microbit-foundation/microbit-reference-design/(threads)

Thread 2 (2017-01-05):

Eagle and KiCad designs don't have the PAD1-3 fix

jaustin, 2017-01-05:
In b2a55fdbed I added a fix from @sjwiseman for the Altium files having PAD1-3 incorrectly mapped out to the external example speaker.

This hasn't yet been added to the KiCad and Eagle designs

Thread 4 (2017-01-06):

contents of micro:bit reference design: web and repo

OwenBrotherwood, 2017-01-06:
From my analysis.

1. https://github.com/microbit-foundation/microbit-reference-design/tree/master/Altium
- should contain the master of the schematic design
- the ascii export, let us call it "ACCEL ASCII" should be included
- it is questionable if any Altium binary blobs for schematics give any meaning in the git repro
- it is questionable if Altium binary blobs for pcb give any meaning in the git repro
2. Concentrate on ensuring the schematic is correct
- remove all pcb designs until this is met and the web should only give a general idea of possibilities with perhaps the main goal of true shareability of schematic design to ensure pcb IRL.
3. Others like Eagle etc etc (the list is endless)
- document import for the interesting list of schematic/pcb sw
- ensure that the import works with active community support for checking
- "if it doesn't work, issue it" and concentrate on issues from people who are actually using the schematic/pcb sw instead of a broad range of possible sw users.

The above are just a few of my thoughts, dependant on feedback to 1 2 3 this issue may come into other areas.

sjwiseman, 2017-01-06:
1) I think that the Altium binary blob _should_ stay. It's the source, like it or not. Everything else is derived.
Yes, any useful derived intermediate files should be published. I didn't think the  Accel was particularly useful. (It's also not something that  I can generate automatically from the outjob.)
2) Not at all convinced by this. The PCB is (imho) an important part of the design. If people want to generate derivative works rather than starting from scratch, it'll save a few days. It's also something to swipe footprints from).
3) Yes! Import was surprisingly flaky and unsatisfactory. Given the maker movement's reliance on reuse, I'm surprised just how hard / bad it was. Obviously I'm spoilt with Altium's generally competent importers.
I'm partly assuming that I'm doing it wrong(tm), and am hoping for assistance from seasoned users of those packages.
I'm somewhat busy at the moment, but will  watch, and do what I can. Shout if there's anything in particular.

OwenBrotherwood, 2017-01-06:
1: Jep: let the blob be in: but never without a commit without the ASCII as documentation for change.
2: Jep: I am basically wanting more concentration on the sch to ensure 100% correct. I am not sure if anyone has actually used the pcb and tested: but I am sure someone will say something.
3: only with a little help from our friends, will the effort come forward: I do stuff as a total amatour and in many ways this gives a good result, relying on open mind and stubbornness.

At the present time: no immediate need for work by @sjwiseman : the documentation of how to export from Altium and import into a subset of interesting sw products is up to the community.

---

My current need for what I believe is "footprints", is the bottom connection layout on the micro:bit, otherwise I will have to do by hand :(

OwenBrotherwood, 2017-01-07:
- Good online:
 - https://circuits.io/
 - https://upverter.com
- Users use:
 - Eagle
- Fun use:
 - Fritzing
- Professional user:
 - Altium

Export/import paths to be found

OwenBrotherwood, 2017-01-07:
Quick list of words

- collaboration
- break down of schematic to easy chunks ala. programing
- version control
- export from source
- community contribution to bring the ball forward
-

and Play and Learn

OwenBrotherwood, 2017-01-08:
No need to join the channel as such, but possible read down from this link
https://microbit-community.slack.com/archives/hardware/p1483829409000042

OwenBrotherwood, 2017-01-08:
"Fork" and also ensure open format exports in pure ascii so that github is used for doc/progress/revisions.

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

OwenBrotherwood, 2017-01-08:
https://upverter.com/acornway/f52fb058b10f0566/acornway-reference-design/

OwenBrotherwood, 2017-01-08:
Export possibilities that are a available at the moment for upverter.com
- with due deference to Altium as source but possible way to another collaboration source with high attention to export to other tools

https://upverter.com/acornway/f52fb058b10f0566/acornway-reference-design/#design-exports

https://forum.upverter.com/t/documentation-for-open-json-format/154

OwenBrotherwood, 2017-01-08:
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

sjwiseman, 2017-01-08:
Ah yes, I remember - rotated components all over the place!
Do you want to raise a ticket with Upverter?

OwenBrotherwood, 2017-01-08:
I think we wait a bit: I would prefer to break the diag. into smaller sections.
I am not sure of the terminology but there should be a way.
For programmers, reading all these lines of code (lines/pin nr etc) is hard: prefer to break into sections from start and reuse with no pain.

sjwiseman, 2017-01-08:
You're welcome to break the design apart, and stitch it all back together with hierarchy - but on a design this small and interconnected, I personally  like to have it all visible.
(I suspect that hierarchy will also open a whole new can of worms when it comes to transferring between packages!)

OwenBrotherwood, 2017-01-09:
I concentrate on learning more import/export and the copper pattern of the edge connector.
Modular ref design could give "something", but as stated: could get wormy

OwenBrotherwood, 2017-01-09:
And seeing what footprints to swipe: but really missing the connector and edge copper
> The PCB is (imho) an important part of the design. If people want to generate derivative works rather than starting from scratch, it'll save a few days. It's also something to swipe footprints from).

sjwiseman, 2017-01-09:
On 9 January 2017 at 10:04, Owen Brotherwood <notifications@github.com>
wrote:

> And seeing what footprints to swipe: but really missing the connector and
edge copper

It's a Modulebit, not a Microtbit(tm). Designed to plug into breadboards,
designed to be a start point for your own project. If you want a  Microbit,
I'd strongly suggest you buy one!
You'll also note it's bigger, to give you some area on the PCB to build
stuff, without interfering with the basic functionality - just blow away
the audio section, and you have a decent amount of space.
No-fit the audio and the battery, and you've (just!) got enough space for a
little breadboard to stick on, then jumper wire to the 0.1" connections.
Or do something else, that's kinda the point :) I wasn't just cloning the
Microbit.

OwenBrotherwood, 2017-01-09:
Or a baggybit
https://github.com/microbit-drill/baggybit :)
Rapidly having a Pi 40 pin interface to pi accessories
with SD flash and i2c extra io or capacitive touch and audio: if enough area
Keeping the present micro:bit v1 and hoping for more ram/flash in v2 and the edge copper on the back of the micro:bit having some i2c extras for i/o :)
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

OwenBrotherwood, 2017-01-09:
Found a nice verified Nordic nRF51822-QFAA with pcb
May not quite be a 	Nordic nRF51822-QFAA-R rev 3 as in tech.microbit.org but I hope it is good enough
https://upverter.com/acornway/9b6866459a4eb097/microbit-raspberry-pi-and-mbed-pins/

I search for other ref design components

OwenBrotherwood, 2017-01-10:
@sjwiseman @jaustin
https://github.com/microbit-foundation/microbit-reference-design/issues/7#issuecomment-271550854 contains the first module of the mega:bit modular system.

OwenBrotherwood, 2017-01-11:
@sjwiseman I found out today that the ic on the ref diagram is not an ic for nRF51822 but a module, as you may have hinted at earlier in the thread (I didn't get the hint :) ).
https://upverter.com/acornway/150e8cc130b43e8d/megabit-Ratac-MDBT40-nRF51822-Module/ is done I think
https://upverter.com/acornway/65697ed30d7e35d3/megabit-nRF51822-QFAA-Module/ will document the implementation of the Ratac module

---

I have done some successfull imports of Eagle today: but Altium sch and pcb from this repro still does not work

OwenBrotherwood, 2017-01-11:
I will be testing plugins for Altium and eagle

Thread 5 (2017-01-06):

micro:bit reference schematic is upside down in Altium

OwenBrotherwood, 2017-01-06:
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

sjwiseman, 2017-01-06:
Can someone (anyone?) replicate this? Certainly doesn't do it here, either on the original or when I open the published version.

OwenBrotherwood, 2017-01-06:
@sjwiseman Can you make the original directly accessible to me by some means?
Also, which version of Altium are you using.
Then I do some work :)

sjwiseman, 2017-01-06:
It's just the red text that's upside down, by the way.  It's in the right place, just inverted. Odd!
It's good here in Altium 14, 16 and 17.freshest , and on 2 PCs across different sites.

OK - some possible progress. Can you double-click some of the red text, and see if the 'Mirror' attribute is set?
It looks as if it's set by default, and ignored - on all versions I've got here. Maybe your eval licensed copy is actually respecting the attribute? Try turning it off, see what happens to the text.
If this is it, I'll fix globally reissue. Very, very odd! (It looks like I set that attribute a few months ago and it's been applied ever since, with no visible effect. Sigh)
Have a version with the attributes cleared.

[Modulebit_004a.zip](https://github.com/microbit-foundation/microbit-reference-design/files/690767/Modulebit_004a.zip)

OwenBrotherwood, 2017-01-07:
On the original ref design: reversing red text. Enclosed pic shows attrib.
I set to 0 degrees and no mirror and it looks good :)
I check with the 4a version

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

OwenBrotherwood, 2017-01-07:
You are just gonna love this one: 180 changed to 0 gives ok text for 004a
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

OwenBrotherwood, 2017-01-07:
My thoughts at present time.
I would prefer the reference design to be a series of schematics that allow for a type of "object" approach that is know from programming.
The schematic is divided into well defined areas in separate schematics.
The schematics can then be combined into a pcb with the areas wished
Closer change control of sections of the design with ASCII and github and versioning

---

It may be "life" that the separate schematics have to be made in Eagle and checked with import into other programs
A clear community support for the work required is possible.
The pcb design being up to whoever has time.

worayoot, 2018-12-24:
From Altium 19
1. Select all (Ctrl+a)
2. Right click on string such as "Magnetometer, Accelerometer" -> Find similar object...
3. Orientation 180 Degree Select from 'Any' to 'Same' -> Click OK
4. At Properties window, change rotation to 0 Degrees and Justification select arrow up right
5. Done

Thread 6 (2017-01-08):

connectors / copper pattern / standard pcb components

OwenBrotherwood, 2017-01-08:
In general, the connectors of the micro:bit are a bit "hard"
The copper pattern, 4 holes and 1.25 stripes need to be a standard component to be cherry picked.
Connectors, 80 1.25 are quite often not available as standard components.

---

Some connectors I have found today: I will probably add to the list as time goes by
http://www.sullinscorp.com/catalogs/62_PAGE64-65_.125_HP_DS_WW_RA.pdf

jaustin, 2017-01-10:
For the connectors, that's more something for the dev-docs repo than the RD one, though I guess we might want to start collecting some useful micro:bit footprints here? Or perhaps in an additional repo called microbit-hw with things someone making accessories could use/need?

OwenBrotherwood, 2017-01-10:
Let us see what I find out of in this week for ensuring something structural and upkeepable

OwenBrotherwood, 2017-01-11:
In order to get parts, schematic and footprint for all micro:bit edge connectors, I have created a requests for https://upverter.com/concierge/
This allows for full micro:bit easy pcb creation if upverter put's in the work
I have asked for the following as I think they the ones needed
EBA40DCAN
EBA40DCBN
EBA40DCCN
EBA40DCWN
EBA40DCTN

I have to find a way to order the copper on the bottom of the micro:bit as a standard element for pcb

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

/cc @sjwiseman

OwenBrotherwood, 2017-04-12:
Proto has now eagle patterns for edge and connector @ https://github.com/proto-pic/micro-bit-eagle-libraries

OwenBrotherwood, 2017-04-12:
Anthony Kirby a KiCad schematic & footprint for the through-hole version of the edge connector socket
 https://github.com/anthonykirby/kicad_microbit_connector

OwenBrotherwood, 2017-04-12:
fritz parts for bottom connector and general pcb for bolt together
https://github.com/make-zurich/micro-bit-badge

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

Thread 7 (2017-01-09):

possible pin out problems or are there  different pin outs per package

OwenBrotherwood, 2017-01-09:
Nordic nRF51822-QFAA-R rev 3 (http://tech.microbit.org/hardware/)
contra
https://upverter.com/eda/#tool=schematic,designId=65697ed30d7e35d3
- see datasheet pdf
example: Vdd 14 (ref design) is i/o in pdf

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

https://github.com/microbit-foundation/microbit-reference-design/blob/master/PDF/Schematic%20Print/Schematic%20Prints.PDF

---
Current reference is
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

https://www.nordicsemi.com/eng/content/download/13358/214991/file/nRF51822_PS%20v2.0.pdf

OwenBrotherwood, 2017-01-10:
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

OwenBrotherwood, 2017-01-10:
The modules schematic is finished with relation to nordic doc.
I try and complete another module and find out how to connect sheets to one pcb
https://upverter.com/acornway/65697ed30d7e35d3/megabit-nRF51822-QFAA-Module/

rolandvs, 2017-01-10:
The VDD on pin 14 is wrong. The symbol is not correct.  The current reference is ok, Also check out/use the latest of the datasheets >=3.3...

jaustin, 2017-01-10:
The pinout used in the reference design is relating to the Raytac module, not the nRF51 SoC itself. So the pinouts are different, yes. Happy for me to close this issue given that explanation?

jaustin, 2017-01-10:
Closing this issue after creating #10 to track clarifying the problem

OwenBrotherwood, 2017-01-10:
The ref design uses modules:
http://tech.microbit.org/hardware/reference-design/

Module Choice
Because the micro:bit uses every pin on the nRF51822, only modules that exposed all of the GPIO of the chip could be used. We have started with the Raytac MDBT40, which is available from outlets like Seedstudio, and commonly used on things like Adafruit BLE boards.

```
This design is fully open source, and we’re happy to accept pull requests for variants that use other modules, or improvements.

For your own projects, using a different module is as simple as wiring the right pins. The hardware page has a detailed pinmap. Likewise, contributions to this pinmap document for other popular modules are welcome.

There is a list of nRF51882 modules maintained by Nordic Semiconductor, from which you could choose any module that has all 31GPIOs broken out. If your design doesn’t use all of the pins on the edge connector and you are able to recompile your software for your custom design (for example using mbed) then you could choose a range of other modules.

```
https://www.nordicsemi.com/eng/Products/3rd-Party-Bluetooth-low-energy-Modules

Closed 2017-01-10.

Thread 10 (2017-01-10):

The schematic doesn't make it clear enough that the nRF51 'block' is provided by a module

jaustin, 2017-01-10:
As per #7 we should find a way to clarify that the nRF51 block in the schematic is the RayTac MDB40T, not a bare nRF, a this could mislead people.

zfm076, 2020-04-08:
> As per #7 we should find a way to clarify that the nRF51 block in the schematic is the RayTac MDB40T, not a bare nRF, a this could mislead people.

Hi,jaustin. Do you know where I can download the schematic and PCB of v1.5 microbit hardware.

Thread 11 (2017-01-10):

pcb-breakout-mdbt40 / bluzDK

OwenBrotherwood, 2017-01-10:
This is a place holder for possible prototyping side track for ref design
I will be trying to import into upverter

If the following is already known, please close the issue

https://github.com/bluzDK/bluzDK
https://github.com/algoaccess/pcb-breakout-mdbt40

Closed 2017-01-12.

Thread 9 (2017-01-10):

MAG module, Freescale Semiconductor	MAG3110FCR1 in progress

OwenBrotherwood, 2017-01-10:
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

jaustin, 2017-01-10:
@OwenBrotherwood can you explain more clearly what the issue you're describing here is please? I can't see what you're suggesting I'm afraid... I presume this is to do with upverter import of the RD?

OwenBrotherwood, 2017-01-10:
yep: issue is general ensure that there is a base for all schematics/pcb for ref design.
The doc for creating is the two references, ref design plus another one.
I cherry pic from reference design

Closed 2017-01-12.

Thread 13 (2018-07-31):

Firmware source code?

flarn2006, 2018-07-31:
Where is the source code for the firmware?

jaustin, 2020-06-22:
@flarn2006 this is a really old issue, but I missed it at the time, and I think it's worth answering it here now anyway in case other people have the same questions.

For the KL26Z the firmware source is the DAPLink project from Arm: https://github.com/ARMmbed/DAPLink

For the nRF51822, you can use different firmware images, but the most common low-level layer is the microbit-dal https://lancaster-university.github.io/microbit-docs/

See https://tech.microbit.org/ for more info on the software/firmware.

Closed 2020-06-22.

Thread 14 (2020-06-21):

Wrong version of PCB.  DO NOT USE.

jdwoodall, 2020-06-21:
The version of the PCB in the step file does not match the current release boards.  DO NOT USE THIS.

jaustin, 2020-06-22:
Hi @jdwoodall - can you confirm what you mean by "release boards" - do you mean the BBC micro:bit, or release boards of the reference design?

I've pre-emptively added some clarification about what the reference design is (and is not) on the README.md in https://github.com/microbit-foundation/microbit-reference-design/commit/b187b1d4fee4ae4edb276b14ff08d78a55a33aa2

Thread 16 (2024-10-24):

Waste o time

Bazmundi, 2024-10-24:
Tried openning the KiCAD versions, got blank PCB, schematic failed with missing libaries and a couple of other obtuse errors.  If you're not supporting, recommend you delete repository

martinwork, 2024-10-24:
Hi @Bazmundi, it seems to work for me.

I cloned this repo, launched KiCad, did File/Open Project and navigated to where the Kicad folder was cloned to find the .pro files.

The total of my knowledge of KiCad is that the installer took a really long time!

Is there something else needed to make it go wrong?

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

martinwork, 2024-10-24:
Oh! I can see the PCB looks blank. On trying to update from schematic... there are dialogues that I don't know how to answer and a list of missing symbol libraries.

These files were produced 8 years ago, presumably from the current version of KiCad. Maybe KiCad has moved on such that it has a problem loading old files? Certainly I don't know how to use it! Perhaps try an older version?

I tried Kicad v4.0.7, in which I could see the schematic in Eeschema. When I tried to see the pcb, there was a message about installing libraries (should have taken a picture - it only shows once!).

I feel it's likely these difficulties are caused by the KiCad UI, not by the files saved here. I need to read the getting started guide...
