microbit-foundation/microbit-reference-design/PDF/Schematic Print/Schematic Prints.PDF

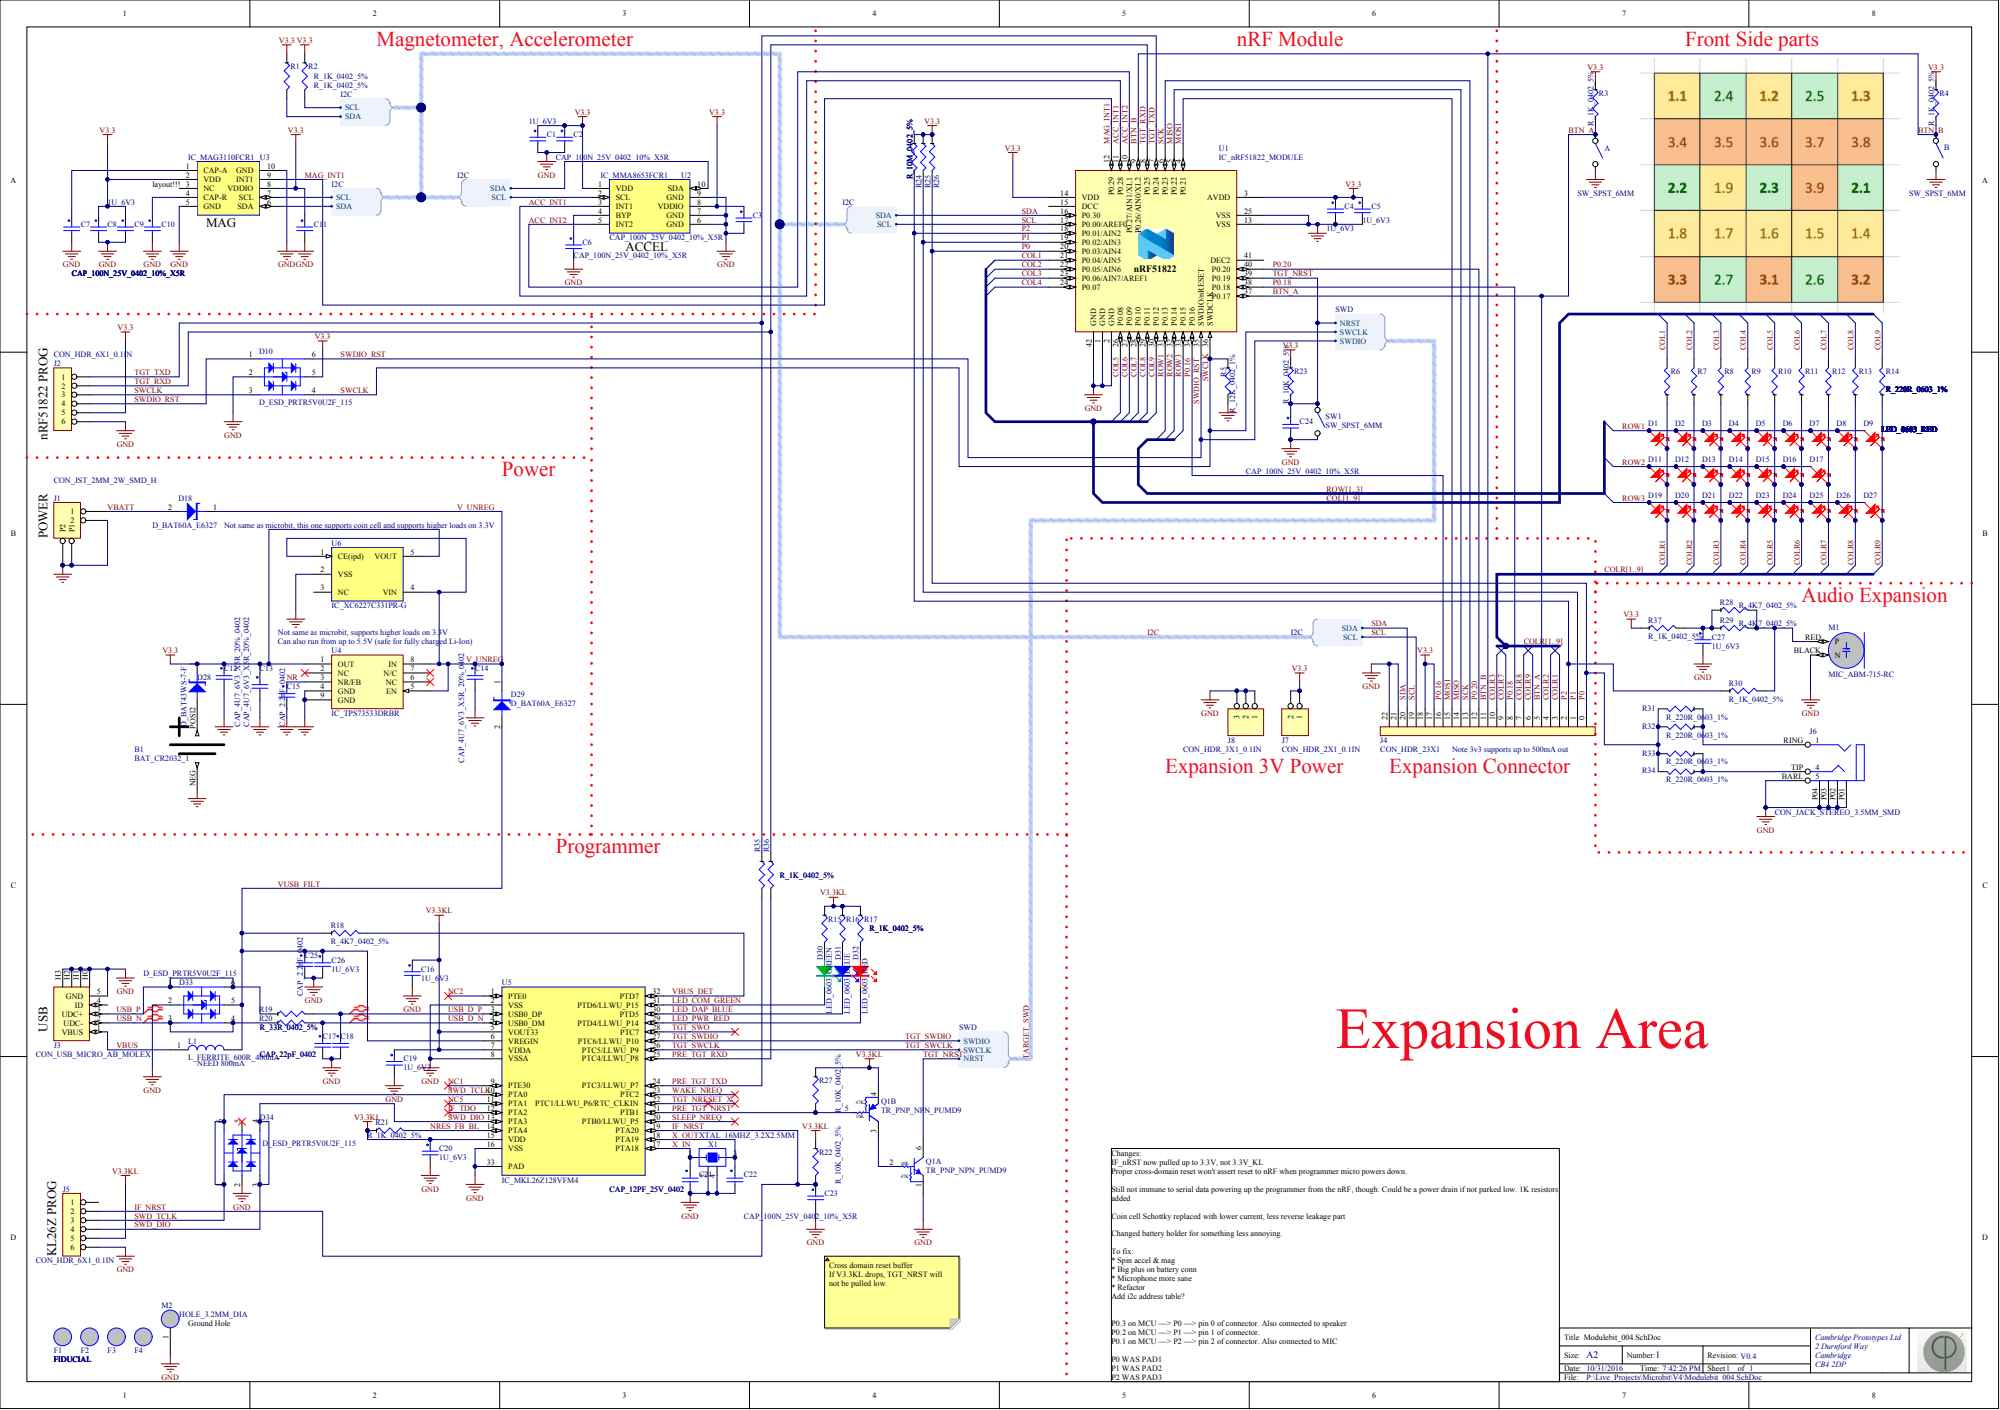
[picture p2: page 1]

SCL | P0.00/AREF0 17
P2 | P0.01/AIN2 18
P1 | P0.02/AIN3 19
P0 | P0.03/AIN4 20 nRF51822 | | P0.20

P0.18
BTN_A

TGT_TXD | 2 | | | 5 | | R23 | SW_SPST_6MM ROW[1..3] COL[1..9]
TGT_RXD
SWCLK | | 3 | | 4 SWCLK
SWDIO_RST

Not same as microbit, this one supports coin cell and supports higher loads on 3.3V

Not same as microbit, supports higher loads on 3.3V
Can also run from up to 5.5V (safe for fully charged Li-Ion)

Note 3v3 supports up to 500mA out

Changes:
IF_nRST now pulled up to 3.3V, not 3.3V_KL
Proper cross-domain reset won't assert reset to nRF when programmer micro powers down.

Still not immune to serial data powering up the programmer from the nRF, though. Could be a power drain if not parked low. 1K resistors
added

SWD_TCLK
SWD_DIO

Coin cell Schottky replaced with lower current, less reverse leakage part

Changed battery holder for something less annoying.

To fix:
* Spin accel & mag
* Big plus on battery conn
* Microphone more sane
* Refactor
Add i2c address table?

Cross domain reset buffer
If V3.3KL drops, TGT_NRST will
not be pulled low.

P0.3 on MCU —> P0 —> pin 0 of connector. Also connected to speaker
P0.2 on MCU —> P1 —> pin 1 of connector.
P0.1 on MCU —> P2 —> pin 2 of connector. Also connected to MIC

Title Modulebit_004.SchDoc | Cambridge Prototypes Ltd 2 Durnford Way Cambridge

Size: A2 | Number: 1 | Revision: V0.4
Date: 10/31/2016 Time: 7:42:26 PM | | Sheet 1 of | CB4 2DP 1
