microbit-foundation/microbit-reference-design/PDF/PCB 3D Print/PCB 3D Prints - Bottom.PDF

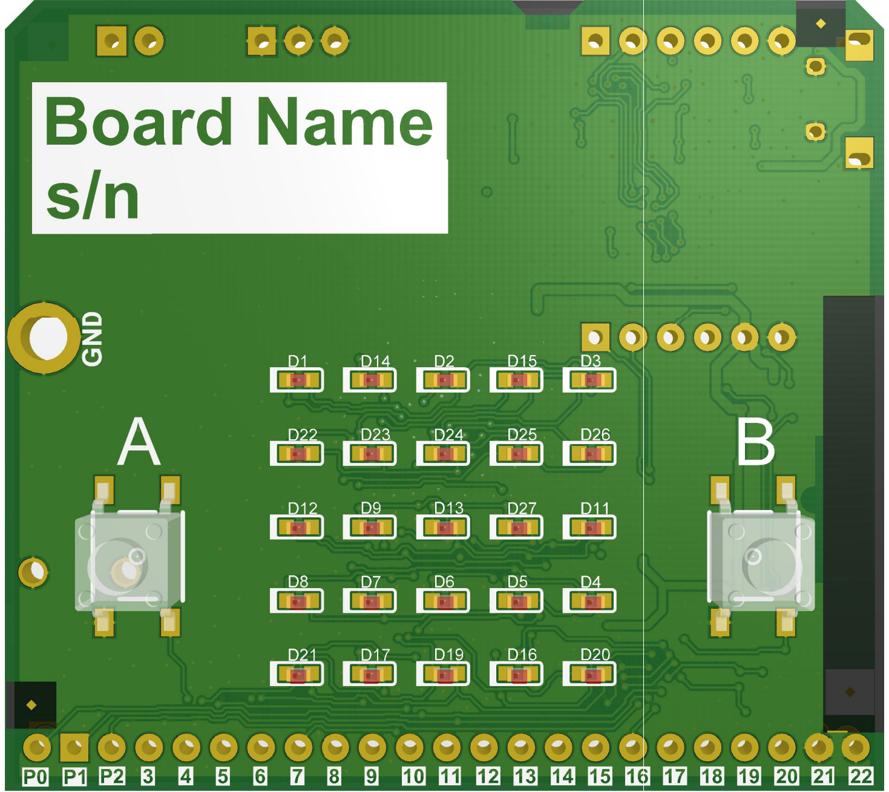
[picture p3: page 1]
