microbit-foundation/microbit-reference-design/PDF/PCB 3D Print/PCB 3D Prints - front.PDF

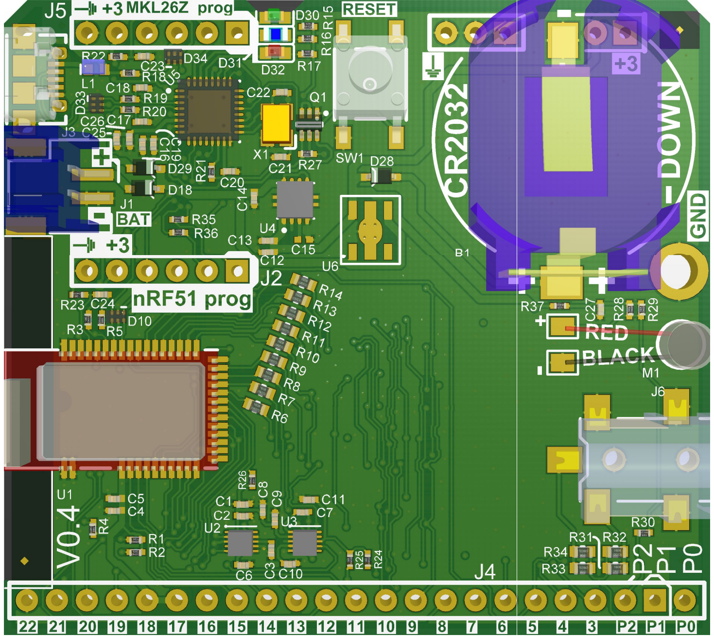
[picture p4: page 1]
