microbit-foundation/microbit-reference-design/PDF/PCB 3D Print/PCB 3D Prints - Top.PDF

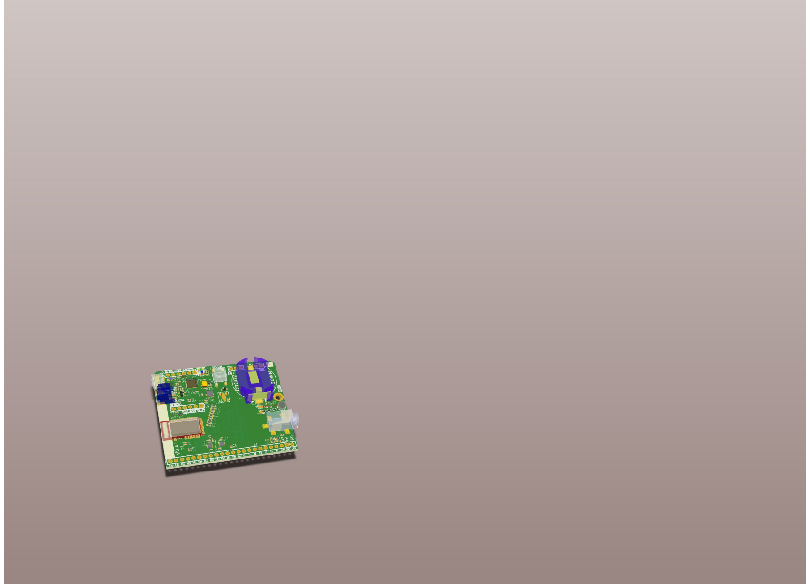
[picture p5: page 1]
