microbit-foundation/microbit-reference-design/PDF/PCB Print/Dimensioned Drawing.PDF

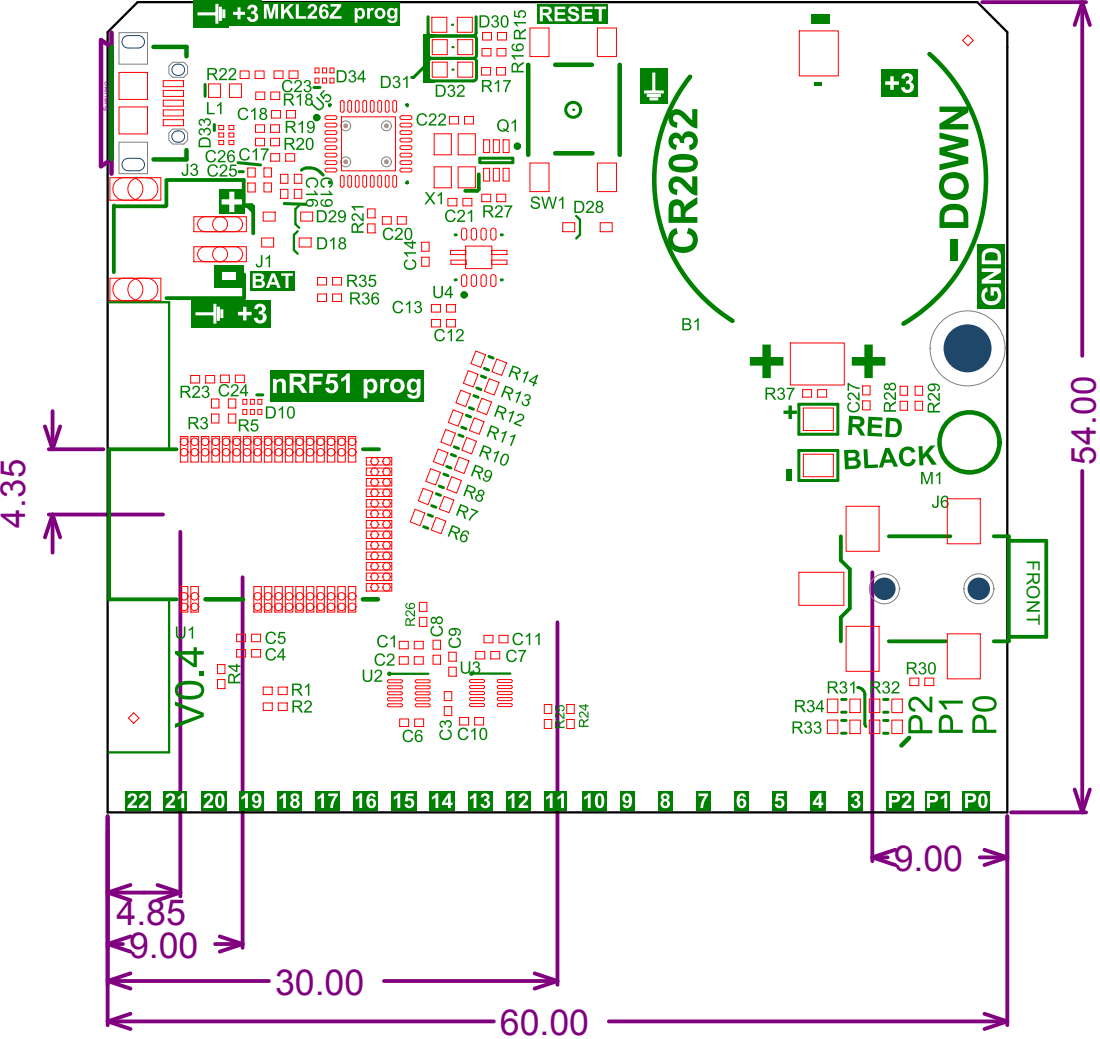
[picture p6: page 1]

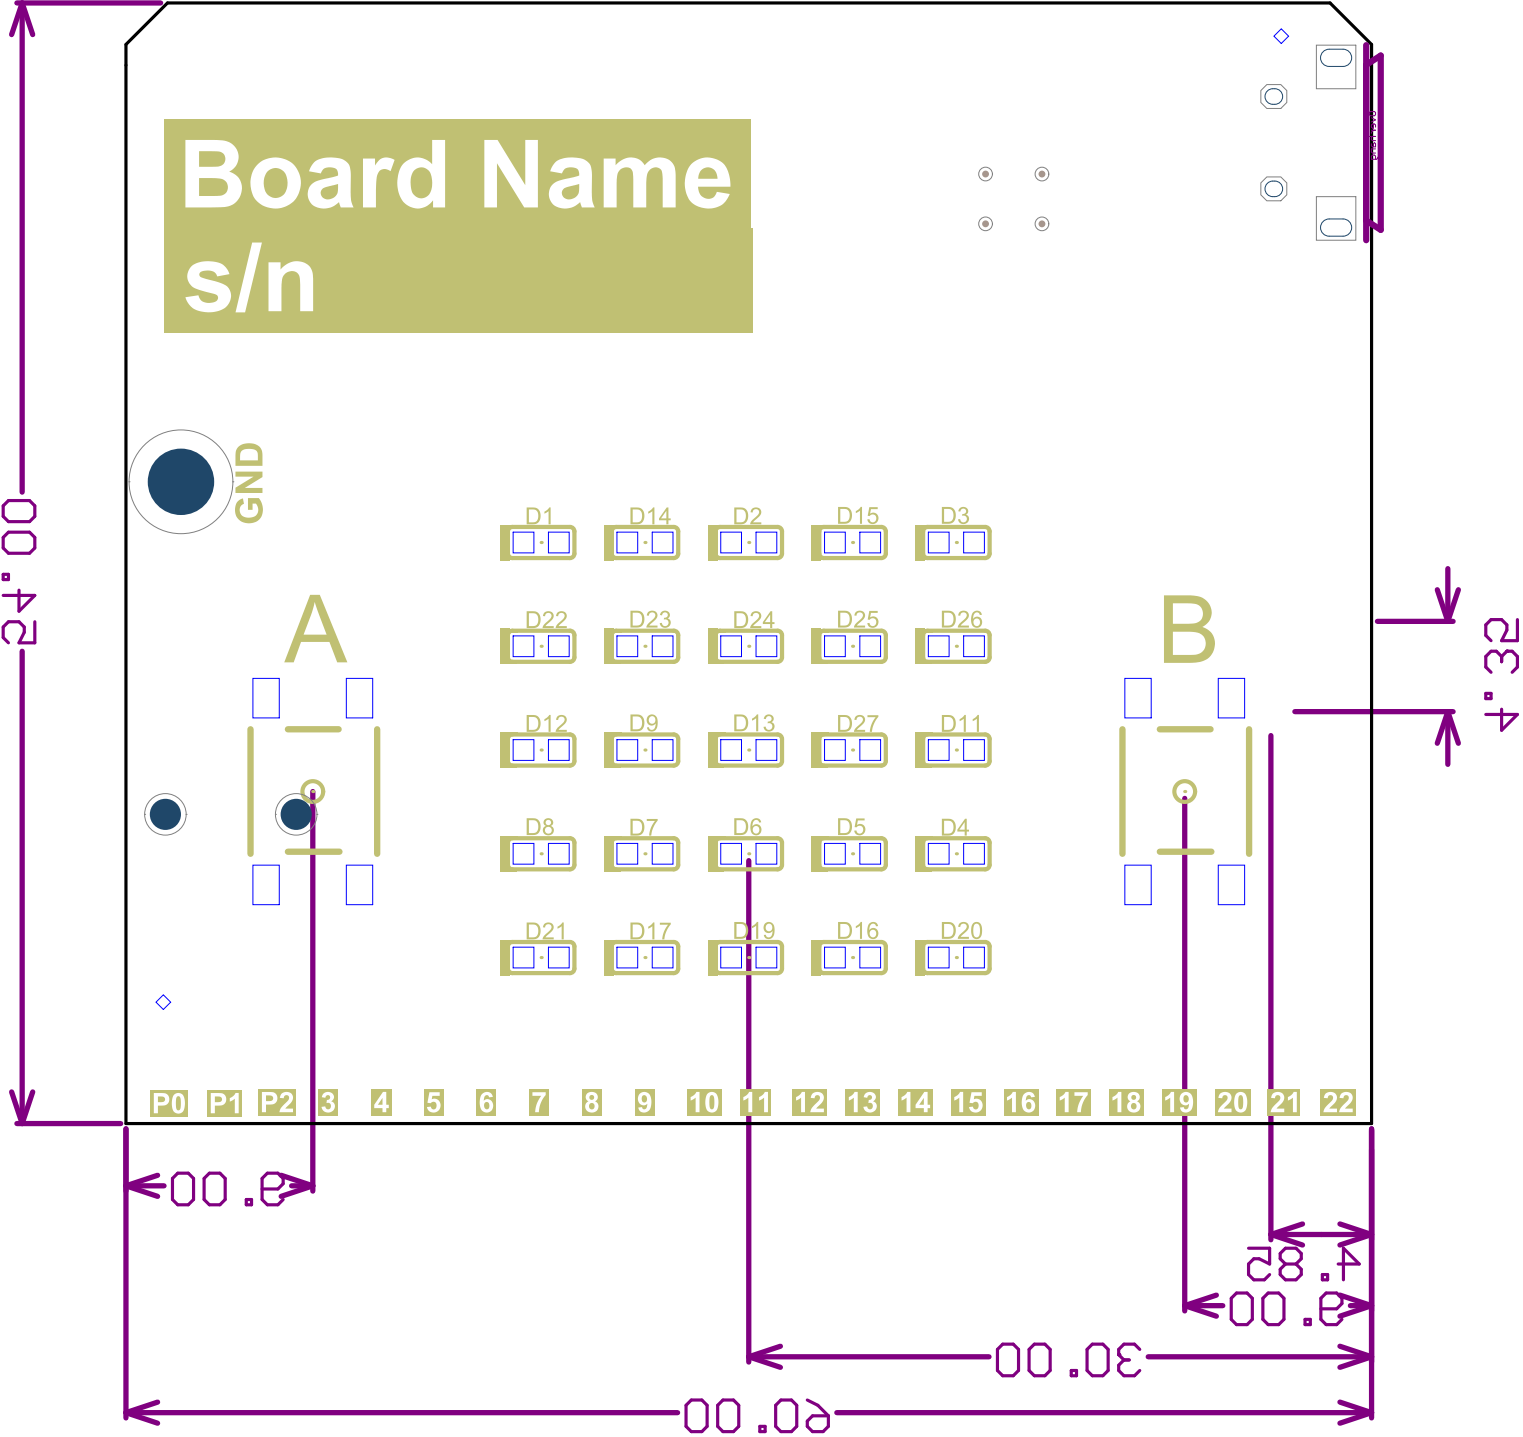
[picture p7: page 2]
