microbit-foundation/microbit-reference-design/PDF/PCB Print/DOUBLE SIDED 1;1 ASSEMBLY.PDF

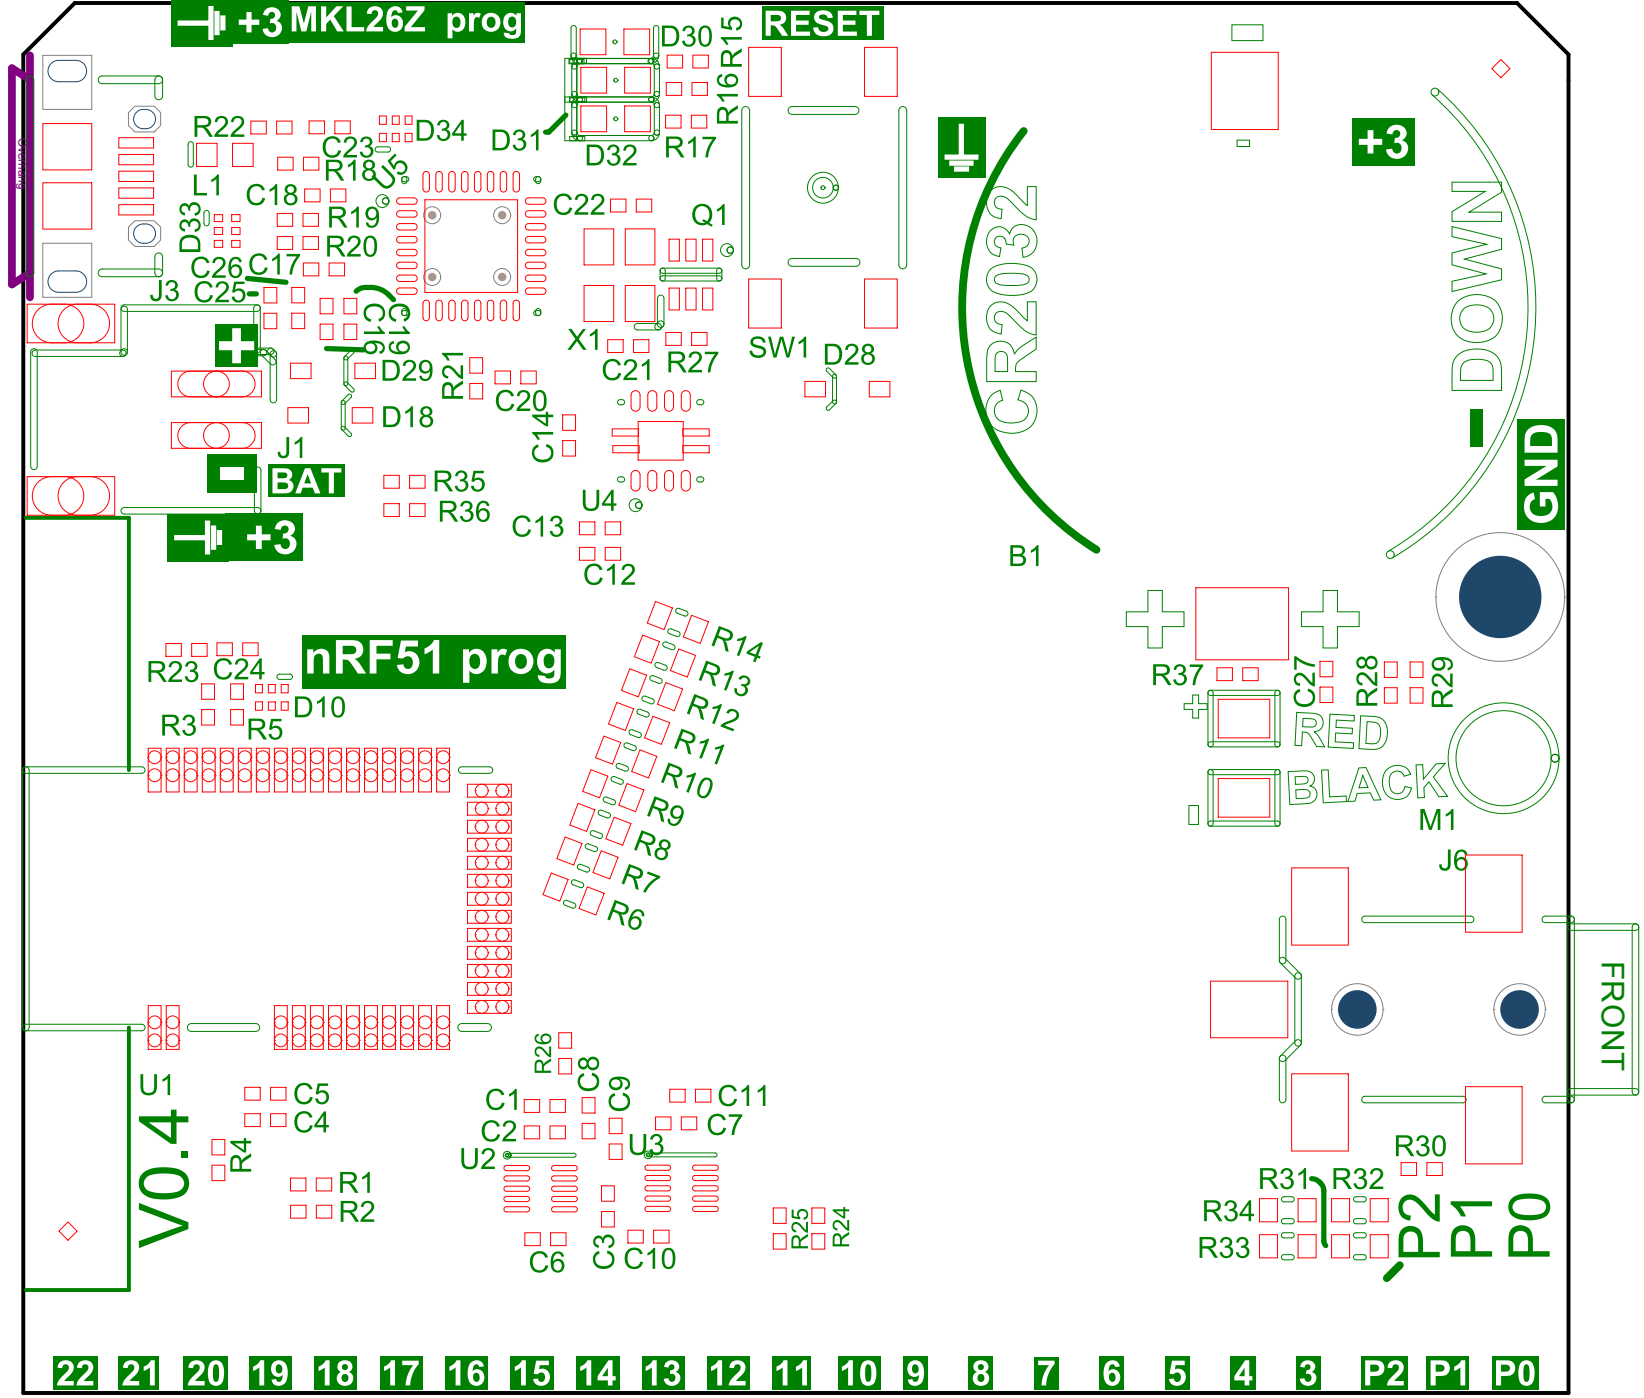
[picture p8: page 1]

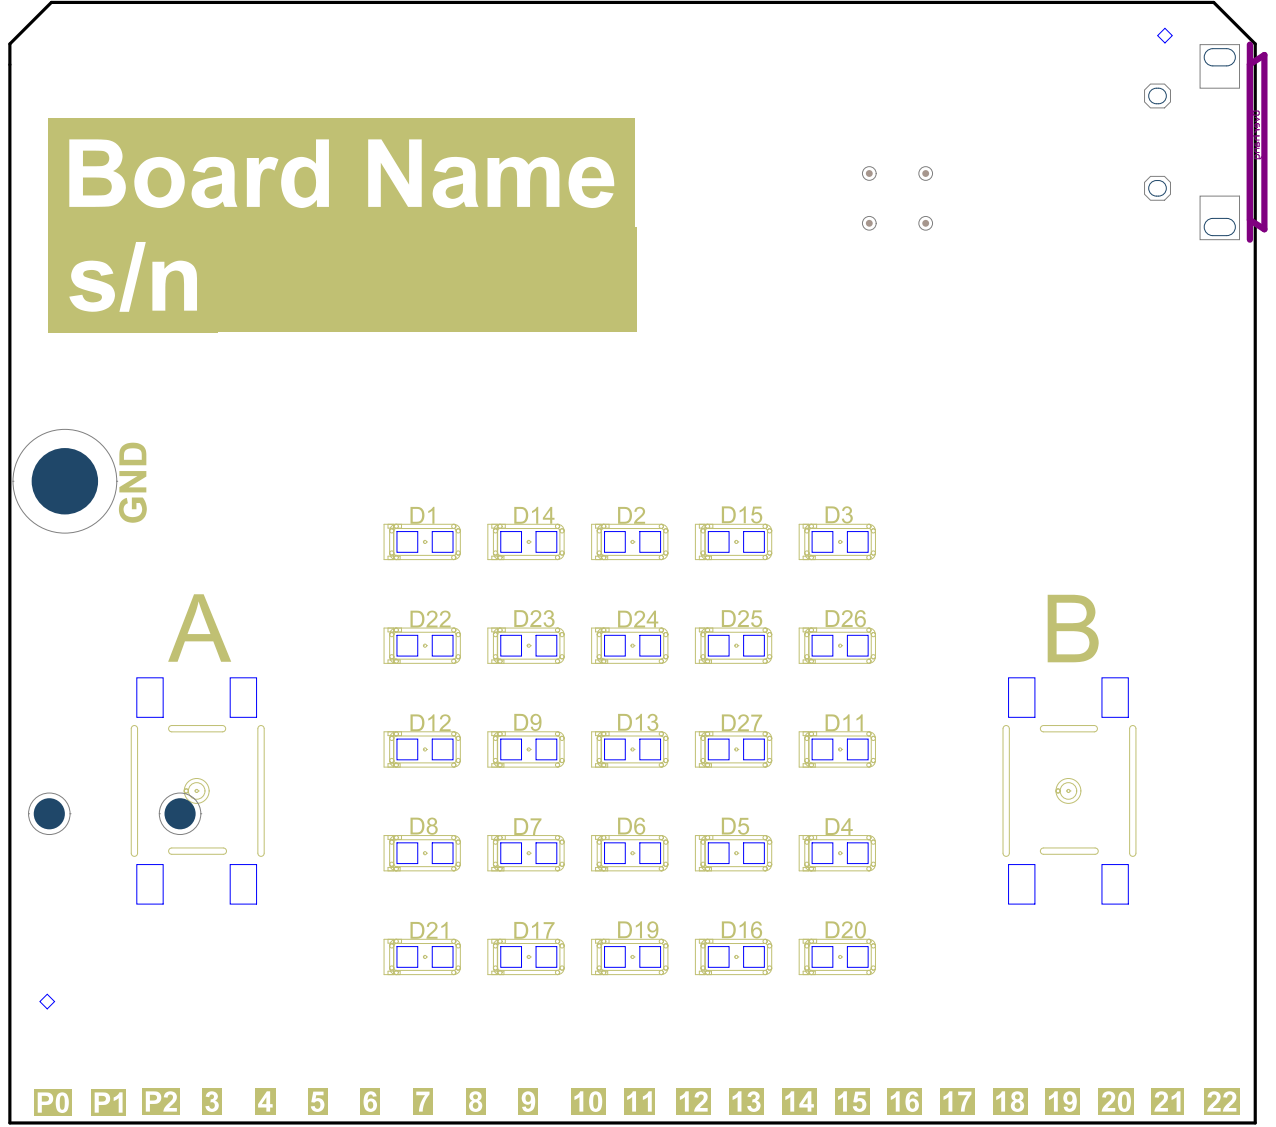
[picture p9: page 2]
