microbit-foundation/microbit-reference-design/(list of files, drawings)

Other design files:
Eagle/Eagle2/MB_004.pcb
Eagle/Eagle2/Modulebit_open_Eagle.SCHLIB
