microbit-foundation/microbit-reference-design/Kicad/Kicad/MBV2.kicad_pcb

## KiCad design kicad/ESP32-CW-KIcad.sch

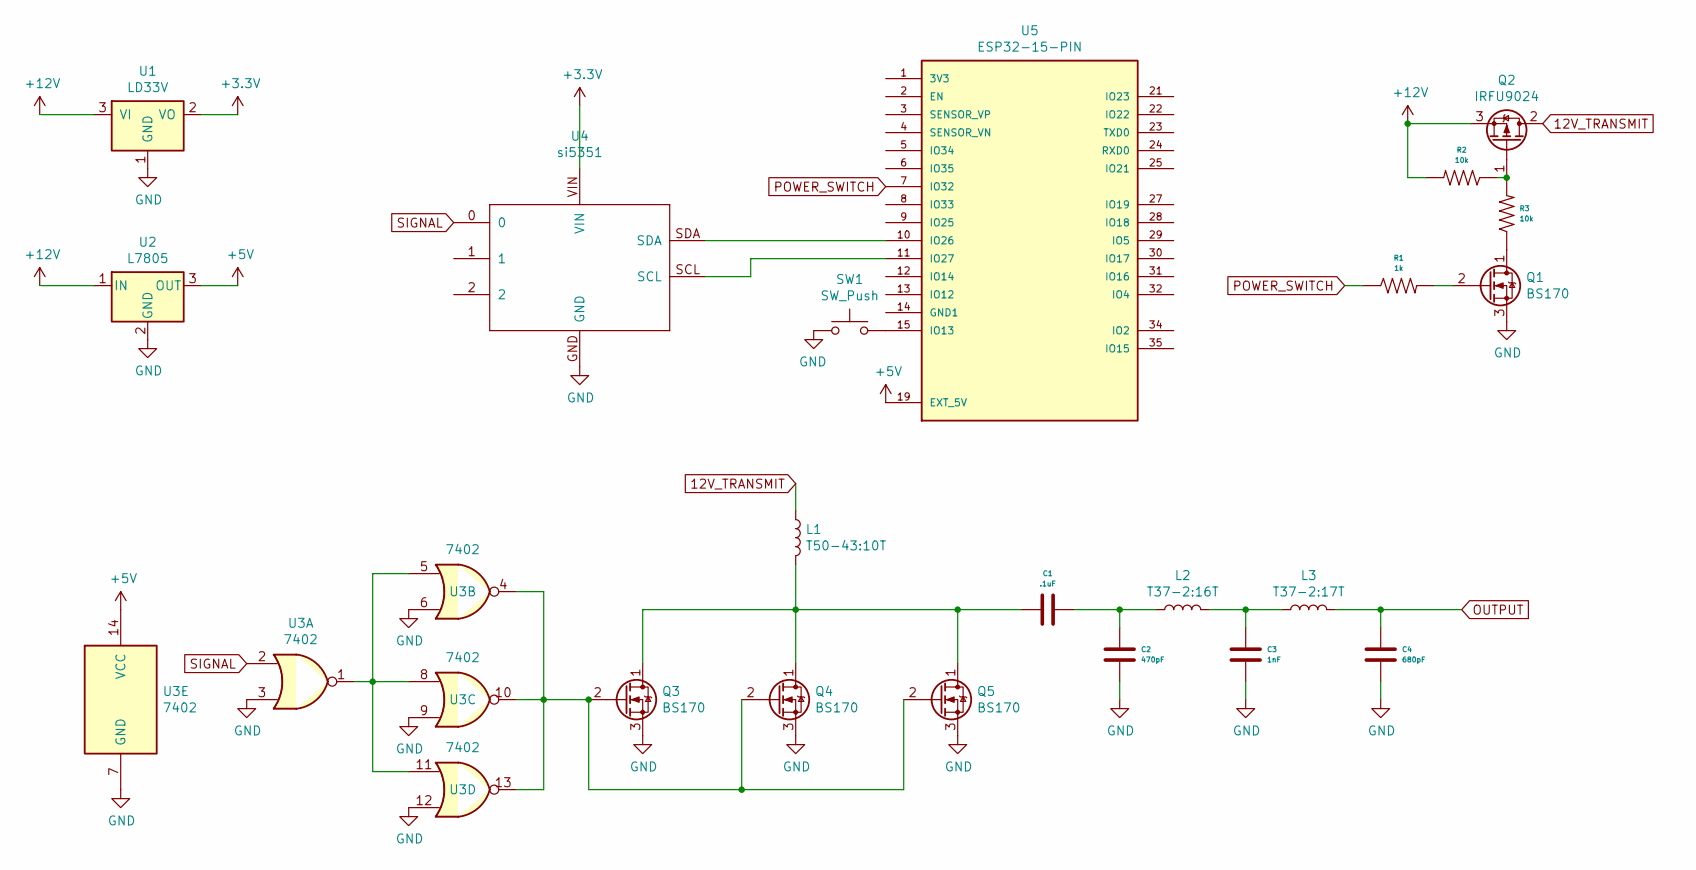
[picture p10: schematic ESP32-CW-KIcad.sch]

Parts:
C1: .1uF
C2: 470pF
C3: 1nF
C4: 680pF
L1: T50-43:10T
L2: T37-2:16T
L3: T37-2:17T
Q1, Q3, Q4, Q5: BS170; TO-92_Inline
Q2: IRFU9024; TO-220-3_Vertical
R1: 1k
R2, R3: 10k
SW1: SW_Push
U1: LD33V
U2: L7805
U3: 7402
U4: si5351
U5: ESP32-15-PIN; PARTREV 4

Connections:
12V_TRANSMIT: L1.1, Q2.2 (D)
+3.3V: U1.2 (VO), U4.VIN
+5V: U2.3 (OUT), U3.14 (VCC), U5.19 (EXT_5V)
+12V: Q2.3 (S), R2.2, U1.3 (VI), U2.1 (IN)
GND: C2.2, C3.2, C4.2, Q1.3 (S), Q3.3 (S), Q4.3 (S), Q5.3 (S), SW1.2, U1.1 (GND), U2.2 (GND), U3.3, U3.6, U3.7 (GND), U3.9, U3.12, U4.GND
unnamed: C1.1, L1.2, Q3.1 (D), Q4.1 (D), Q5.1 (D)
unnamed: C1.2, C2.1, L2.1
unnamed: C3.1, L2.2, L3.1
unnamed: Q1.1 (D), R3.1
unnamed: Q1.2 (G), R1.2
unnamed: Q2.1 (G), R2.1, R3.2
unnamed: Q3.2 (G), Q4.2 (G), Q5.2 (G), U3.4, U3.10, U3.13
unnamed: SW1.1, U5.15 (IO13)
unnamed: U3.1, U3.5, U3.8, U3.11
unnamed: U4.SCL, U5.11 (IO27)
unnamed: U4.SDA, U5.10 (IO26)
OUTPUT: C4.1, L3.2
POWER_SWITCH: R1.1, U5.7 (IO32)
SIGNAL: U3.2, U4.0
