microbit-foundation/microbit-reference-design/(commit log)

2016-10-19 Initial import of the micro:bit reference design
    Licensed under the Solderpad license
    http://solderpad.org/licenses/SHL-0.51/
    [Bill of Materials-Modulebit_open_V0.3.xlsx, Inhouse_assembly_PnP-ModulebitV0_3(FIRSTBUILD).csv, MBV2.kicad_pcb, MBV2.sch, MBV3.kicad_pcb, MBV3.sch, MB_004.pcb, Modulebit_open_Eagle.SCHLIB]
2017-01-05 Update with SW-compatible speaker wiring/PADs
    The original version of the RD reproduced an error in the spec
    that resulted in PAD0-3 being labelled incorrectly. This meant
    that the example 'Speaker' reference part of the circuit didn't
    work with the default micro:bit software pin allocations.
    I was hoping to be able to update all the versions at once, but as
    this bug is out there it's better to fix it now and do the others
    ASAP.
    This is a fix for the Altium parts of the RD
